chengmania/ArduTrx/ArduTrxShield/kicad_source/ArduTrxShieldPNP.csv

Reference | Value | Datasheet | Footprint | Qty | DNP
CN7 | 691322310002 |  | CON_wuerth:WR-TBL_691322310002 | 1
