chengmania/ArduTrx/ArduTrxShield/kicad_source/ArduTrxShield.kicad_pcb

## KiCad design ArduTrxShield/kicad_source/ArduTrxShield.kicad_pcb (2024-10-25)

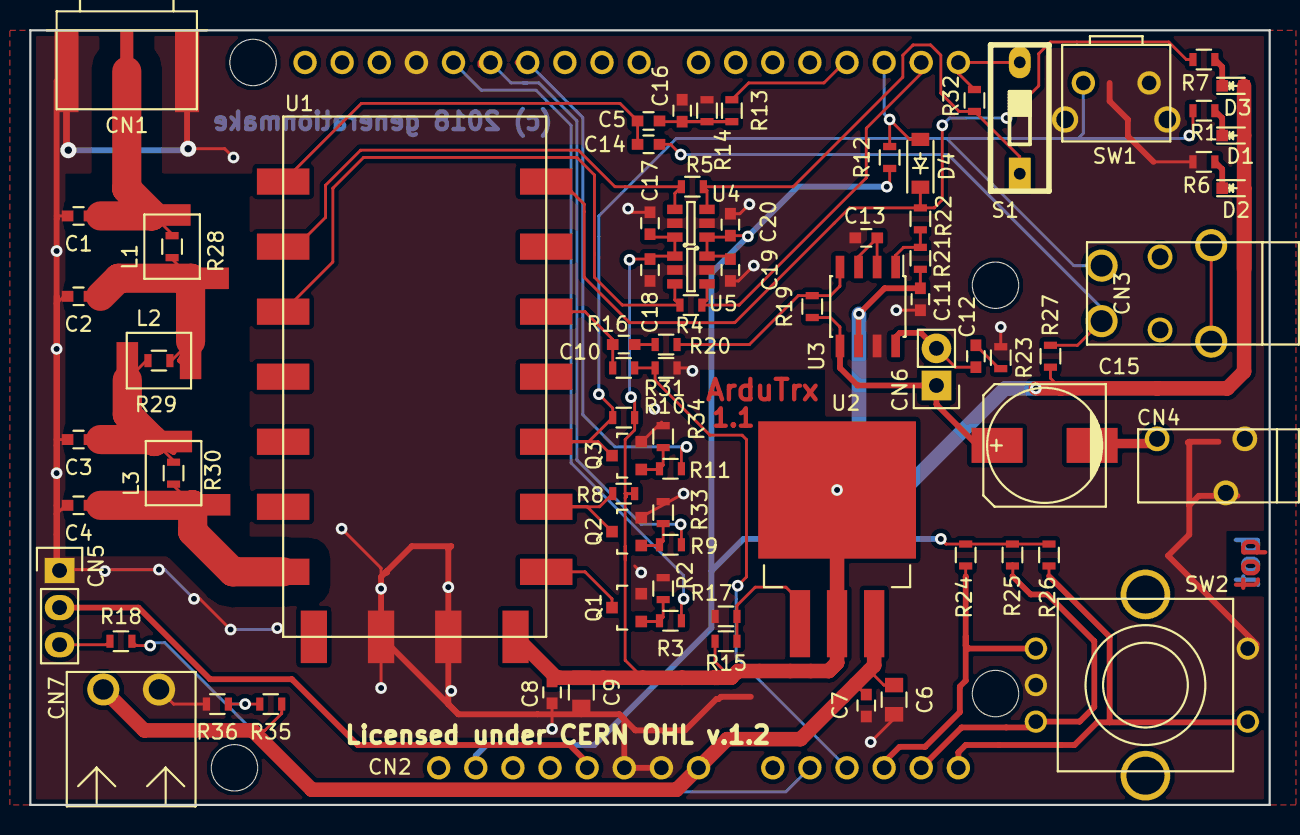
[picture p1: board ArduTrxShield.kicad_pcb from above]

Board: 2 copper layers, 84.8 x 53.0 mm, 81 parts (0 on the bottom side), 48 nets.

Parts:
C1, C4: 30p; C_0603
C2, C3: 47p; C_0603
C5, C7, C8, C10, C11, C12, C14, C16, C17, C18, C19, C20: 100n; C_0603
C6, C9: 10u; C_0805
C13: 1u; C_0603
C15: 470u; c_elec_8x10.5
CN1: 60312202114509; WR-SMA-PCB
CN2: ARDUINO
CN3: CON_KLINKE3; 1503_07
CN4: CON_KLINKE3; 1501_03
CN5: CONN_01X03; Pin_Header_Straight_1x03
CN6: CONN_01X02; Pin_Header_Straight_1x02
CN7: 691322310002; WR-TBL_691322310002
D1: Led_red; LED_0603
D2: Led_yellow; LED_0603
D3: Led_green; LED_0603
D4: BAT46ZFILM; SOD-123
L1, L2, L3: 744912156; WE-CAIR_4248
Q1, Q2, Q3: 2N7002; SOT-23
R1, R6, R7, R8, R10, R14, R16, R24, R25, R26, R31: 1k; R_0603
R2, R12, R13, R21, R27, R33, R34: 4k7; R_0603
R3, R9, R11, R18, R22: 100; R_0603
R4, R5, R28, R29, R30, R32: DNI; R_0603
R15: 121; R_0603
R17: 300; R_0603
R19, R20, R36: 20k; R_0603
R23: 2k; R_0603
R35: 100k; R_0603
S1: SW_DIP_x1; dip_1-300
SW1: TAST_HOR; WE_4312x6xxx7x6
SW2: ALPS_EC11E
U1: DRA818
U2: LT1085; TO-263-3Lead
U3: LM4871; SOIC-8_3.9x4.9mm_Pitch1.27mm
U4, U5: SN74LVC1T45; SOT-23-6

Connections:
+5V: CN2.27, CN5.2
/AF_OUT: C10.2, R16.1, U1.3
/AF_OUT_R: CN2.21, R16.2, R31.1
/ANT0: C4.1, L3.2, R30.1, U1.12
/ANT1: C3.1, L2.2, L3.1, R29.1, R30.2
/ANT2: C2.1, L1.2, L2.1, R28.1, R29.2
/ANT3: C1.1, CN1.1, L1.1, R28.2
/ENC_A: CN2.20, R24.2, SW2.A
/ENC_B: CN2.19, R25.2, SW2.B
/ENC_SW: CN2.18, R26.2, SW2.E
/GPS_RX: CN2.22, R18.1, R35.2, R36.1
/H_L: Q1.3, U1.7
/H_L_Q: CN2.13, R3.1
/MIC: C14.1, CN3.2, R27.2
/MIC_IN: C5.2, C14.2, U1.18
/MIC_IN_R: CN2.3, R13.1
/PD: Q2.3, R8.2, U1.6
/PD_Q: CN2.12, R9.1
/PTT: CN3.1, Q3.3, R1.2, R10.2, SW1.3, U1.5
/PTT_Q: CN2.11, R11.1
/RXD: CN2.0, R32.1, S1.2
/RXD_R: R5.2, U1.17, U5.4
/RXD_S: R5.1, R32.2, S1.1, U5.3
/SPKR: C15.2, CN4.3
/SQ: D4.1, R7.2, R22.2, U1.1
/SQ_R: CN2.2, D4.2, R12.2
/TXD: CN2.1, R4.1, U4.4
/TXD_R: R4.2, U1.16, U4.3
GND: C1.2, C2.2, C3.2, C4.2, C6.2, C7.2, C8.2, C9.2, C11.2, C13.2, C16.2, C17.2, C18.2, C19.2, C20.2, CN1.2, CN1.3, CN1.4, CN1.5, CN2.14, CN2.25, CN2.26, CN4.1, CN4.2, CN5.1, CN7.2, Q1.2, Q2.2, Q3.2, R2.2, R6.2, R14.2, R17.2, R23.2, R31.2, R33.2, R34.2, R36.2, SW1.1, SW1.2, SW1.4, SW2.C, SW2.D, U1.9, U1.10, U3.7, U4.2, U4.5, U5.2, U5.5
unnamed: C10.1, R20.2
unnamed: C12.1, CN6.2, U3.8
unnamed: C12.2, R23.1
unnamed: C13.1, U3.2, U3.3
unnamed: C15.1, CN6.1, R19.1, U3.5
unnamed: C5.1, C16.1, R13.2, R14.1
unnamed: CN5.3, R18.2
unnamed: D1.1, R1.1
unnamed: D2.1, R6.1
unnamed: D3.1, R7.1
unnamed: Q1.1, R2.1, R3.2
unnamed: Q2.1, R9.2, R33.1
unnamed: Q3.1, R11.2, R34.1
unnamed: R15.2, R17.1, U2.1
unnamed: R19.2, R20.1, U3.4
unnamed: R21.2, R22.1, U3.1
VCC: C8.1, C9.1, C11.1, C17.1, C18.1, D1.2, D2.2, D3.2, R8.1, R10.1, R15.1, R21.1, R27.1, U1.8, U2.2, U2.4, U3.6, U4.1, U5.6
VIN: C6.1, C7.1, CN2.24, CN7.1, R35.1, U2.3
VIO: C19.1, C20.1, CN2.30, R12.1, R24.1, R25.1, R26.1, U4.6, U5.1
