chengmania/ArduTrx/(notices)

Notices in the files:
ArduTrxShield/kicad_source/ArduTrxShield.sch:
This documentation describes Open Hardware and is licensed
under the CERN OHL v. 1.2.
of the CERN OHL v.1.2. (http://ohwr.org/cernohl). This documentation
ArduTrxShield/kicad_source/ArduTrxShield.kicad_pcb:
Licensed under CERN OHL v.1.2
(c) 2018 generationmake
